peloja/robot-ultrasonic-bluetooth-motorsDC/README.md

# robot-ultrasonic-bluetooth-motorsDC
Proyecto en el que se controla un robot móvil utilizando un arduino.

En el pdf adjunto se encuentra todo lo necesario para entender el proyecto.
