peloja/robot-ultrasonic-bluetooth-motorsDC/Modo7.ino

int MotorDer1 = 13; //El pin 13 de arduino se conecta con el pin In1 del L298N
int MotorDer2 = 11; //El pin 11 de arduino se conecta con el pin In2 del L298N
int MotorIzq1 = 9; //El pin 9 de arduino se conecta con el pin In3 del L298N
int MotorIzq2 = 8; //El pin 8 de arduino se conecta con el pin In4 del L298N
int PWM_Derecho = 12; //El pin 12 de arduino se conecta con el pin EnA del L298N
int PWM_Izquierdo = 10; //El pin 10 de arduino se conecta con el pin EnB del L298N
int ENC_IZ = 21; //Encoder izquierdo
int ENC_DE = 20; //Encoder derecho


int pwm_iz = 70, pwm_de = 70, K = 1, error_vel=0, error_rpm_iz = 0, error_rpm_de = 0, refbt, caso = 0;
float rpm_ref = 70;
unsigned long tiempo = 0, tiempo_f = 0, muestreo_ant = 0, muestreo = 0;
long int tick_iz, tick_de;
float rpm_iz, rpm_de, dis_der, dis_izq, dis_cent, x = 0, y = 0, phi = 0;
const float radio = 3.25, b = 10; //cm
double Kvel=0.2;

void setup() {
  //Configuramos los pines como salida
  pinMode(MotorDer1, OUTPUT);
  pinMode(MotorDer2, OUTPUT);
  pinMode(MotorIzq1, OUTPUT);
  pinMode(MotorIzq2, OUTPUT);
  pinMode(PWM_Derecho, OUTPUT);
  pinMode(PWM_Izquierdo, OUTPUT);
  //Pines de interrupción de los encoders
  attachInterrupt(digitalPinToInterrupt(ENC_IZ), countTicks_iz, CHANGE);//Interrupción del encoder izquierdo
  attachInterrupt(digitalPinToInterrupt(ENC_DE), countTicks_de, CHANGE);//Interrupción del encoder derecho
  //Arrancamos los puertos serie
  Serial.begin (9600);
  Serial2.begin (38400); //Puerto serie para Bluetooth
}

void loop() {
  muestreo = millis(); //Tiempo de muestreo
  //  if (Serial.available() > 0) { //Chequeo de disponibilidad del puerto serie para envío Bluetooth
  //    refbt = Serial.parseInt();
  //    if (refbt != 0) {
  //      rpm_ref = refbt;
  //    }
  //  }
  if (muestreo - muestreo_ant >= 50) { //Calculo de los rpm de cada rueda, cada 100ms
    rpm_iz = ((float)tick_iz / 384) / 0.00166667; //Cálculo de las rpm de las ruedas, midiendo los ticks incrementales
    rpm_de = ((float)tick_de / 384) / 0.00166667; //desde la última medición

    dis_der = ((float)tick_de / 384) * (2 * PI * radio); //Distancia recorrida en cm por la rueda derecha
    dis_izq = ((float)tick_iz / 384) * (2 * PI * radio); //Distancia recorrida en cm por la rueda izquierda
    dis_cent = (dis_der + dis_izq) / 2; //Distancia recorrida por el centro del robot

    tick_iz = 0;
    tick_de = 0;

    x = x + (dis_cent * cos(phi)) * 1.3; //Factor de escala medido experimentalemente
    y = y + (dis_cent * sin(phi)) * 1.3;
    phi = phi + ((dis_der - dis_izq) / b);

    error_rpm_iz = rpm_ref - rpm_iz; //Calculamos el error entre la medicion real de rpm de cada rueda y la referenca
    error_rpm_de = rpm_ref - rpm_de; //Este error se lo restamos o sumamos al pwm de modo que es proporcional al error.
    error_vel = rmp_iz - rpm_de;//error de las velocidades para mantener recto
        
    if(error_vel>3) pwm_de = pwm_de + error_vel*Kvel;
    else if(error_vel<-3) pwm_iz = pwm_iz + abs(error_vel*Kvel);    

    if (error_rpm_iz > 0) pwm_iz = pwm_iz + 2.5; //Vamos sumando o restando un offset de 5 a los pwm a medida que se requiere de aumentar o disminuir las rpm
    else pwm_iz = pwm_iz - 2.5;

    if (error_rpm_de > 0) pwm_de = pwm_de + 2.5;
    else pwm_de = pwm_de - 2.5;

    if (abs(pwm_iz) > 220) pwm_iz = 220; //Saturamos los valores pwm del motor
    if (abs(pwm_de) > 220) pwm_de = 220;

    switch (caso) {
      case 0:
        if (x < 100) {
          avanza(abs(pwm_iz), abs(pwm_de)); //Avanza
          Serial.println(String(muestreo - muestreo_ant) + " " + String(x) + " " + String(y) + " " + String(phi));
          //break;
        }
        else {
          pivote_izq();
          Serial.println(String(muestreo - muestreo_ant) + " " + String(x) + " " + String(y) + " " + String(phi));
          if (phi >= PI / 2) {
            para();
            delay(1000);
            caso = 1;
            y=0;
          }
        }
        break;
      case 1:
        if (y < 100) {
          avanza(abs(pwm_iz), abs(pwm_de)); //Avanza
          Serial.println(String(muestreo - muestreo_ant) + " " + String(x) + " " + String(y) + " " + String(phi));
          //break;
        }
        else {
          pivote_izq();
          Serial.println(String(muestreo - muestreo_ant) + " " + String(x) + " " + String(y) + " " + String(phi));
          if (phi >= PI) {
            para();
            delay(1000);
            caso = 2;
            x=100;
          }
        }
        break;
      case 2:
        if (x > 0) {
          avanza(abs(pwm_iz), abs(pwm_de)); //Avanza
          Serial.println(String(muestreo - muestreo_ant) + " " + String(x) + " " + String(y) + " " + String(phi));
          //break;
        }
        else {
          pivote_izq();
          Serial.println(String(muestreo - muestreo_ant) + " " + String(x) + " " + String(y) + " " + String(phi));
          if (phi >= 1.5 * PI) {
            para();
            delay(1000);
            caso = 3;
            y=100;
          }
        }
        break;
      case 3:
        if (y > 0) {
          avanza(abs(pwm_iz), abs(pwm_de)); //Avanza
          Serial.println(String(muestreo - muestreo_ant) + " " + String(x) + " " + String(y) + " " + String(phi));
          //break;
        }
        else {
          para();
          Serial.println(String(muestreo - muestreo_ant) + " " + String(x) + " " + String(y) + " " + String(phi));
          delay(1000);
          caso = 4;
        }
        break;
      case 4:
        para();
        break;
    }
    muestreo_ant = muestreo;
  }

}

void countTicks_iz() { //Rutina de interrupción encoder izquierdo
  tick_iz++;
}
void countTicks_de() { //Rutina de interrupción encoder derecho
  tick_de++;
}

void para() { //Orden de parar
  digitalWrite(MotorDer1, LOW);
  digitalWrite(MotorDer2, LOW);
  digitalWrite(MotorIzq1, LOW);
  digitalWrite(MotorIzq2, LOW);
}


void avanza(double pwmizq, double pwmder) { //Orden de avanzar
  digitalWrite(MotorDer1, HIGH);
  digitalWrite(MotorDer2, LOW);
  analogWrite(PWM_Derecho, pwmder + 5);
  digitalWrite(MotorIzq1, HIGH);
  digitalWrite(MotorIzq2, LOW);
  analogWrite(PWM_Izquierdo, pwmizq);
}

void pivote_izq() { //Orden de pivotar a la izquierda
  digitalWrite(MotorDer1, HIGH);
  digitalWrite(MotorDer2, LOW);
  digitalWrite(MotorIzq1, LOW);
  digitalWrite(MotorIzq2, HIGH);
  analogWrite(PWM_Derecho, 90);
  analogWrite(PWM_Izquierdo, 90);
}
